DerekJenkins197/Senior_Project/README.md

# Senior_Project
A hub for file sharing and to centralize our software in one place.
