DerekJenkins197/Senior_Project/Design_Documentation/tex_files/System_Architecture.tex

\subsection{Overview}
The Smart Trigger is a self-contained, battery-powered embedded system that
adds an electronic authorization step to the mechanical operation of an AR-15.
Functionally, it is a closed loop with three stages: Sense, Decide, Act.

\subsection{Design Requirements}
\input{tex_files/DesignReqs.tex}
