DerekJenkins197/Senior_Project/Figures/Mech_FSD.png

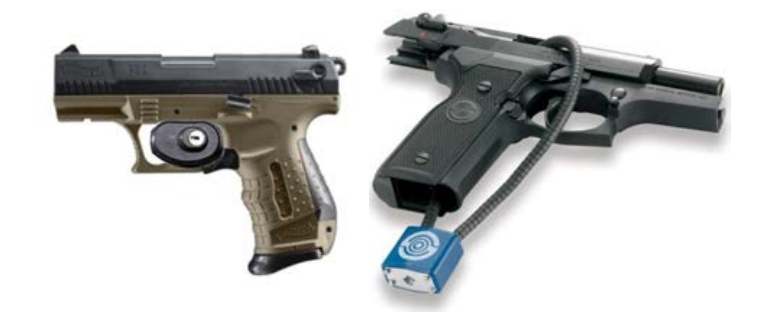
Figures/Mech_FSD.png
