DerekJenkins197/Senior_Project/Antenna_Embedded_Grip.stl

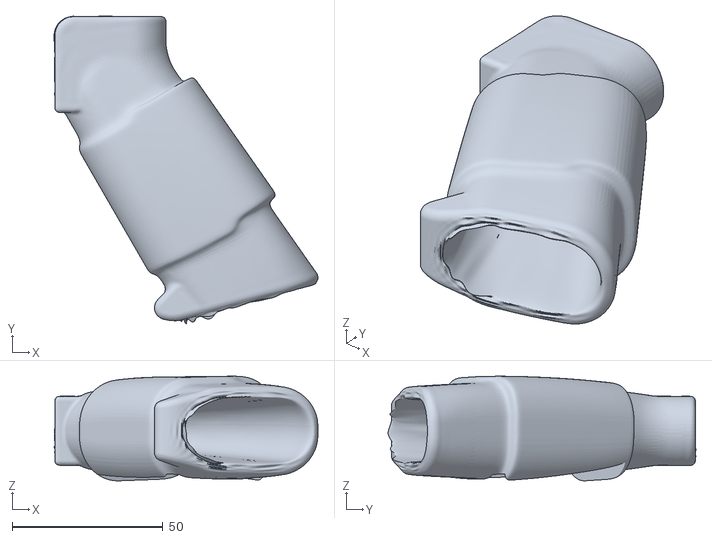
[picture p10: CAD file, 2026-10-02]
Antenna_Embedded_Grip.stl
87.6 x 102.1 x 34.7
