DerekJenkins197/Senior_Project/EBB/EBB.kicad_pcb

## KiCad design EBB/EBB.kicad_pcb (2026-10-31)

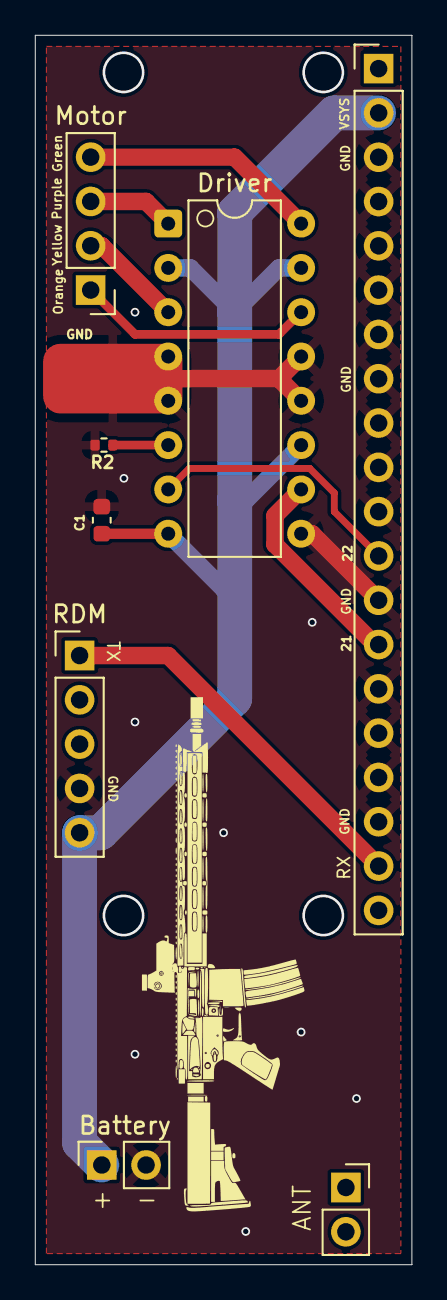
[picture p11: board EBB.kicad_pcb from above]

Board: 2 copper layers, 21.6 x 70.5 mm, 8 parts (0 on the bottom side), 10 nets.

Parts:
Battery: Conn_01x02; PinSocket_1x02_P2.54mm_Vertical
C1: 100nF; C_0603_1608Metric
Driver: Motor_Driver; DIP-16_W7.62mm
GND: SolderWirePad_1x01_SMD_4x8mm
J6: Motor; PinHeader_1x04_P2.54mm_Vertical
Pico1: Conn_01x20_MountingPin; PinHeader_1x20_P2.54mm_Vertical
R2: 47K; R_0402_1005Metric
RDM: RDM Pins; PinHeader_1x05_P2.54mm_Vertical

Connections:
+5V: Battery.1, C1.1, Driver.2, Driver.8, Driver.11, Driver.15, Pico1.2, RDM.5
/GPIO_21: Driver.10, Pico1.14
/GPIO_22: Driver.7, Pico1.12
/Green: Driver.16, J6.4
/Orange: Driver.14, J6.1
/Purple: Driver.1, J6.3
/TX: Pico1.19, RDM.1
/Yellow: Driver.3, J6.2
GND: Battery.2, C1.2, Driver.4, Driver.5, Driver.9, Driver.12, Driver.13, GND.1, Pico1.3, Pico1.4, Pico1.5, Pico1.6, Pico1.7, Pico1.8, Pico1.9, Pico1.10, Pico1.11, Pico1.13, Pico1.15, Pico1.16, Pico1.17, Pico1.18, R2.1, RDM.4
unnamed: Driver.6, R2.2
