DerekJenkins197/Senior_Project/step_demo/Src/step_demo.c

#include "main.h"
#include "stm32f0xx_hal.h"
#include "stm32f0xx.h"
#include "stepper.h"

void SystemClock_Config(void);

void LED_init(void) {
    // Initialize PC9 (green LED) to show each step
    RCC->AHBENR |= RCC_AHBENR_GPIOCEN;                                          // Enable peripheral clock to GPIOC
    GPIOC->MODER &= ~GPIO_MODER_MODER9;
    GPIOC->MODER |= GPIO_MODER_MODER9_0;                                        // Set PC9 to output
    GPIOC->OTYPER &= ~GPIO_OTYPER_OT_9;                                         // Set to push-pull output type
    GPIOC->OSPEEDR &= ~GPIO_OSPEEDR_OSPEEDR9;                                    // Set to low speed
    GPIOC->PUPDR &= ~GPIO_PUPDR_PUPDR9;                                         // Set to no pull-up/down
    GPIOC->ODR &= ~GPIO_ODR_9;                                                  // Shut off LED
}

/**
  * @brief  The application entry point.
  * @retval int
  */
int main(void)
{
  /* Reset of all peripherals, Initializes the Flash interface and the Systick. */
  HAL_Init();
  /* Configure the system clock */
  SystemClock_Config();

  LED_init();
  stepper_init();       // PC0 pulses once per second, PC3 sets direction

  while (1)
  {
  }
  return -1;
}

/**
  * @brief System Clock Configuration
  * @retval None
  */
void SystemClock_Config(void)
{
  RCC_OscInitTypeDef RCC_OscInitStruct = {0};
  RCC_ClkInitTypeDef RCC_ClkInitStruct = {0};

  /** Initializes the RCC Oscillators according to the specified parameters
  * in the RCC_OscInitTypeDef structure.
  */
  RCC_OscInitStruct.OscillatorType = RCC_OSCILLATORTYPE_HSI;
  RCC_OscInitStruct.HSIState = RCC_HSI_ON;
  RCC_OscInitStruct.HSICalibrationValue = RCC_HSICALIBRATION_DEFAULT;
  RCC_OscInitStruct.PLL.PLLState = RCC_PLL_NONE;
  if (HAL_RCC_OscConfig(&RCC_OscInitStruct) != HAL_OK)
  {
    Error_Handler();
  }

  /** Initializes the CPU, AHB and APB buses clocks
  */
  RCC_ClkInitStruct.ClockType = RCC_CLOCKTYPE_HCLK|RCC_CLOCKTYPE_SYSCLK
                              |RCC_CLOCKTYPE_PCLK1;
  RCC_ClkInitStruct.SYSCLKSource = RCC_SYSCLKSOURCE_HSI;
  RCC_ClkInitStruct.AHBCLKDivider = RCC_SYSCLK_DIV1;
  RCC_ClkInitStruct.APB1CLKDivider = RCC_HCLK_DIV1;

  if (HAL_RCC_ClockConfig(&RCC_ClkInitStruct, FLASH_LATENCY_0) != HAL_OK)
  {
    Error_Handler();
  }
}

/**
  * @brief  This function is executed in case of error occurrence.
  * @retval None
  */
void Error_Handler(void)
{
  /* User can add their own implementation to report the HAL error return state */
  __disable_irq();
  while (1)
  {
  }
}

#ifdef USE_FULL_ASSERT
void assert_failed(uint8_t *file, uint32_t line)
{
}
#endif /* USE_FULL_ASSERT */
