DerekJenkins197/Senior_Project/(commit log)

2026-05-01 Added Design Approach, Current Status, and Stretch Goals
2026-09-28 Add stepper motor control module for STM32
2026-10-02 Added .stl file for custom AR grip
    [Antenna_Embedded_Grip.stl]
2026-10-06 Here are the files for our stepper motor demo.
2026-10-20 Added files for the PCB board in Kicad
2026-10-20 Added a different approach to PCB
    Connects everything in a glorified bread board
2026-10-20 New design for PCB
2026-10-24 Added newer version of PCB
    Still need to work on floor planning
2026-10-25 Updated KiCad files with pcb and footprints
2026-10-31 Added some body about the blocker design and a table with the bill of materials. Not currently building.
2026-10-31 Document custom PCB design rationale and tradeoffs
    Added rationale for custom PCB design and tradeoffs for revised design approach, including details on component integration and assembly considerations.
2026-11-04 Added test code for new motor spec in motor_test
2026-11-05 Added to the RFID Module and Stepper Motor. Still needs some updates to fix some grammer and to add citations
2026-11-05 Added reference to for the Stepper Motor
2026-11-05 Fixed some flow and grammer errors so it sounds more professional
2026-11-05 Added the correct type of stepper motor
